Max-Quax/S23_42_NAVAIR_DAD/Requirements Specification.xlsx

Sheet: Version Control
Version No | Date | Version Control Page. Requirements are on the next page
2 | 2022-09-14
2.1 | 2022-09-16
2.2 | 2022-09-21
2.3 | 2022-09-23
2.4 | 2022-10-06
2.5 | 2022-10-15
2.6 | 2022-10-16
2.7 | 2022-10-19
2.8 | 2022-10-26
2.9 | 2022-10-29
2.10. | 2022-11-10
2.11 | 2022-11-13
2.12 | 2022-11-16

Sheet: Requirements Section
Product Name | Data Acquisiton Device
Product Description | The product consists of the Data Acquisition Device (DAD) and its Remote Sensor Array (RSA). The purpose of this device is to aid ground crew in diagnosing, detecting and addressing potential issues on their aircraft. During operation, the user will place the RSA on the aircraft. The user may interface with the DAD’s UI to pair the sensors. While running diagnostics on the aircraft, the DAD will record, process and display real time data for the user. When the user is finished, they should be able to safely power off the device. The DAD should be rechargeable. The user should be able to recharge the DAD while in use.
Product Version | v2.9
Last Updated | 2022-10-29
Category | REQ-# | Priority | Requirement | Version # | Notes
Functional | FUN-1 | 1 | Data Acquisition Device SHALL have sensors that connect wirelessly to the handheld device | v2
 | FUN-2 | 1 | Data Acquisition Device SHALL display live sound data's average intensity | v2
 | FUN-3 | 3 | Data Acquisition Device SHALL display live sound data as an FFT | v2
 | FUN-4 | 1 | Data Acquisition Device SHALL display live vibration data's average intensity | v2
 | FUN-5 | 3 | Data Acquisition Device SHALL display live vibration data as an FFT | v2
 | FUN-6 | 1 | Data Acquisition Device SHALL have a sensor for vibration sensing | v2 | Sensor type is not critical. Velocimeter is industry standard. Return value in meters/sec
 | FUN-8 | 1 | Data Acquisition Device SHALL have a microphone for sound sensing | v2
 | FUN-9 | 1 | Data Acquisition Device SHALL have a sensor for ambient temperature sensing | v2.9 | Sensor type is unimportant. Split this requirement for ambient and point temp (v2.9)
 | FUN-11 | 1 | Data Acquisition Device SHALL have a relative humidity sensor | v2
 | FUN-12 | 2 | Data Acquisition Device SHOULD have wireless sensors that transmit data without need for line of sight to handheld device | v2.7
 | FUN-13 | 3 | Data Acquisition Device SHOULD be able to successfully recover from power loss | v2
 | FUN-14 | 3 | Data Acquisition Device SHALL have enough storage for at least 1 full battery's worth of data collection with an additional 20% margin | v2 | Specific capacity can only be determined after testing
 | FUN-15 | 1 | Data Acquisition Device SHALL comprise of at least one of every type of sensor (vibration, sound, point temperature, ambient temperature, relative humidity) | v2.9 | Adjusted wording to reflect the fact that the customer was agnostic about sensor type, they only care about the type and quality of data we collect. (v2.9)
 | FUN-16 | 5 | Data Acquisition Device SHOULD have hot-swappable sensors | v2.7
 | FUN-17 | 5 | Data Acquisition Device SHOULD update FFT output at least once every 5 seconds (0.2Hz) | v2.5
 | FUN-18 | 4 | Data Acquisition Device SHOULD accommodate at least 8 sensors in total | v2.5 | Max's addition- This was not ported from a previous iteration of the specs. LMK if this shouldn't be in here.
 | FUN-19 | 4 | Data Acquisition Device SHOULD be able to automatically identify each sensor | v2.8
 | FUN-20 | 2 | Data Acquisition Device SHALL provide user with a visual indication of what sensor is which | v2.9 | Edited wording
 | FUN-21 | 4 | Data Acquisition Device SHOULD allow user to attach a description to each sensor from within the UI | v2.8
 | FUN-22 | 1 | Data Acquisition Device SHALL have a sensor for point temperature sensing | v2.9
Performance | PER-1 | 2 | Data Acquisition Device SHALL have a connectivity range of at least 50 feet between the sensors and handheld device | v2
 | PER-2 | 2 | Data Acquisition Device SHALL have readily interpretable output data | v2
 | PER-3 | 3 | Data Acquisition Device SHALL collect at least 10k sound samples per second | v2
 | PER-4 | 3 | Data Acquisition Device SHALL collect at least 10k vibration samples per second | v2
 | PER-5 | 3 | Data Acquisition Device SHALL collect at least 1 temperature sample per second | v2
 | PER-6 | 3 | Data Acquisition Device SHALL collect at least 1 humidity sample per second | v2
 | PER-7 | 3 | Data Acquisition Device SHALL have a maximum microphone sound pressure level of 125dB | v2
 | PER-8 | 3 | Data Acquisition Device SHALL have a maximum vibration sensor intensity of 2 inches per second | v2
 | PER-9 | 3 | Data Acquisition Device SHALL have a maximum temperature sensor temperature of 100C | v2.9 | Removed "212F" (v2.9)
 | PER-10 | 3 | Data Acquisition Device SHALL have a maximum humidity sensor relative humidity of 100% | v2
 | PER-11 | 4 | Remote Sensor Array mounts SHALL be able to withstand vibrations of intensity of at least 2 m/s | v2
 | PER-12 | 4 | Data Acquisition Device SHALL update all data to touchscreeen at least once per second | v2.8 | v2.8
 | PER-13 | 3 | Data Acquisition Device SHALL be able to output minimum temperature readings of -25C | v2.8
 | PER-14a | 3 | Data Acquisition Device SHALL be able to output temperature readings with a precision of 0.5C | v2.9 | After conversation with teammate, this was changed to "precision", rather than "accuracy"
 | PER-14b | 3 | Data Acquisition Device SHALL be able to output vibration readings to within 5% accuracy over its accurate range | v2.8
 | PER-15 | 3 | Data Acquisition Device SHALL be able to output vibration readings over a range of 20Hz to 5kHz | v2.8 | This was described as a "fuzzy bottom" range. Readings were requested to be "fairly flat" over this range
 | PER-16 | 3 | Data Acquisition Device SHALL be able to output humidity readings to within 5% accuracy over its accurate range | v2.8 | Ideal value of 1%
 | PER-17 | 3 | Data Acquisition Device SHALL be able to output humidity readings over an accurate range of 10%-90% humidity | v2.8 | Customer described this as the absolute minimum acceptable. Ideally wants full range.
 | PER-18 | 3 | Data Acquisition Device SHALL have a minimum microphone sound pressure level of 50dB | v2.8
 | PER-19 | 3 | Data Acquisition Device SHALL be able to output sound pressure level readings to within 5dB over its accurate range | v2.8 | Customer described an ideal value of +/- 1dB accuracy
 | PER-20 | 3 | Data Acquisition Device SHALL be able to output microphone readings over a range of 20Hz to 5kHz | v2.8
 | PER-21 | 1 | Data Acquisition Device SHALL have a temperature sensor accurate within +/-5% | v2.8 | Moved requirement. Used to be FUN-10
Compliance
Environmental
Reliability
Power | POW-1 | 3 | Data Acquisition Device SHALL have a battery life of at least 4 hours | v2
 | POW-2 | 2 | Remote Sensor Array SHALL have a battery life of at least 4 hours | v1
Mechanical | MEC-1 | 3 | Data Acquisition Device SHALL have a handheld device weight of no more than 10 pounds | v2
 | MEC-2 | 4 | Remote Sensor array SHALL be smaller than the handheld device | v2.6 | Deleted MEC-5 (duplicate)
 | MEC-3 | 4 | Data Acquisition Device SHOULD have sensors be as small as possible | v2
 | MEC-4 | 2 | Data Acquisition Device SHALL have sensors that can be a coupled to a surface and held in place | v2.11 | Deleted repeated requirement (MEC-6)
 | MEC-7 | 4 | Sensor to sensor array cable length SHALL be limited to less than 65 feet | v2.9 | Changed wording to clarify where the cables are going (2.9)
 | MEC-8 | 5 | Data Acquisition Device SHOULD have some degree of water resistance | v2.8
 | MEC-9 | 5 | Data Acquisition Device SHOULD have some degree of dust resistance | v2.8
 | MEC-10 | 5 | Remote Sensor Array SHOULD have some degree of water resistance | v2.8
 | MEC-11 | 5 | Remote Sensor Array SHOULD have some degree of dust resistance | v2.8
 | MEC-12 | 3 | Data Acquistition Device SHOULD not reach temperatures above 40 C | v2.8 | Actual temperature is interpretation of "too hot to handle"
 | MEC-13 | 2 | Data Acquisition Device SHOULD only use reproducible connection ports | v2.9 | Actual ports used does not matter, as long as they can be found and recreated.
 | MEC-14 | 4 | Data Acquisition Device SHALL have minimum cable lengths of 25 feet | v2.10
 | MEC-15 | 5 | Data Acquisition Device SHOULD have a handheld device with an 8inx3inx6in maximum size | v2.11
 | MEC-16 | 5 | Data Acquisition Device SHOULD have a touchscreen with at least 4in diagonal length | v2.11
Input/Output | I/O-1 | 1 | Data Acquisition Device SHALL output sensor data to standardized removable media | v2
 | I/O-2 | 2 | Data Acquisition Device SHALL have easily accessible output data | v2
 | I/O-3 | 2 | Data Acquisition Device SHALL have easily interpretable output data | v2
Testing
Configuration
Cost
Schedule | SCH-1 | 1 | The Team SHALL present a Critical Design Review by 11/27/2022. | v1 | This will include the schedule, budget status and any relevant project information.
 | SCH-2 | 3 | The Customer and SME SHALL be invited to the CDR no less than 1 week in advance. | v1
 | SCH-3 | 1 | The team SHALL present a Preliminary Design Review by 10/16/22. | v1 | This will include the design architecture, target specification and work breakdown
Safety

Sheet: Verification Devices
Devices Needed
Weight Scale
Camera
Logic Analyzer
Function Generator
Oscilliscope/Spectrum Analyzer
SD Card Reader
Premade Temperature Sensor
Premade Humidity Sensor
Premade Vibration Sensor
Premade Microphone
Power Supply
Laptop
Multimeter
