Max-Quax/S23_42_NAVAIR_DAD/MDE Team 42 Project Files/Hardware/Enclosure Design Files/RSA_BOTTOM_FULL_V2.stl

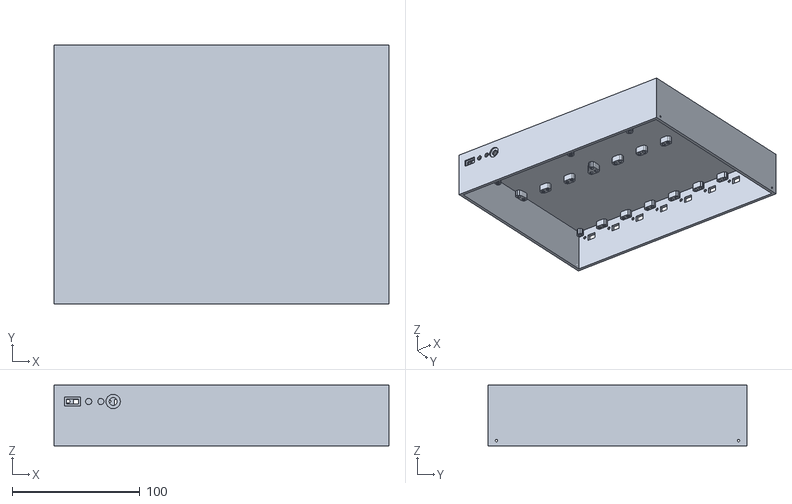
[picture p1: CAD file, 2023-05-04]
MDE Team 42 Project Files/Hardware/Enclosure Design Files/RSA_BOTTOM_FULL_V2.stl
262.6 x 203.0 x 47.6
