Max-Quax/S23_42_NAVAIR_DAD/MDE Team 42 Project Files/Hardware/Enclosure Design Files/RSA_TOP_FULL_V3.stl

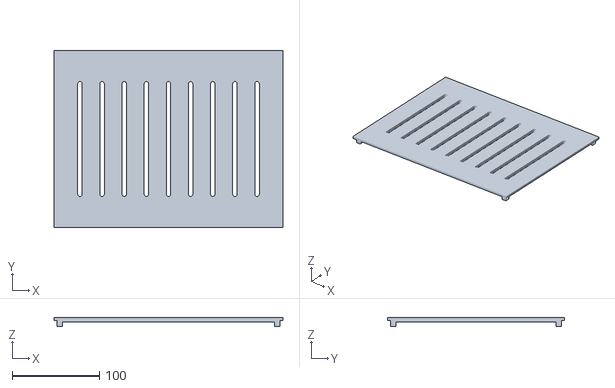
[picture p2: CAD file, 2023-05-04]
MDE Team 42 Project Files/Hardware/Enclosure Design Files/RSA_TOP_FULL_V3.stl
262.6 x 203.0 x 9.84
