Max-Quax/S23_42_NAVAIR_DAD/MDE Team 42 Project Files/Hardware/Enclosure Design Files/SENSOR_BOTTOM_V2.stl

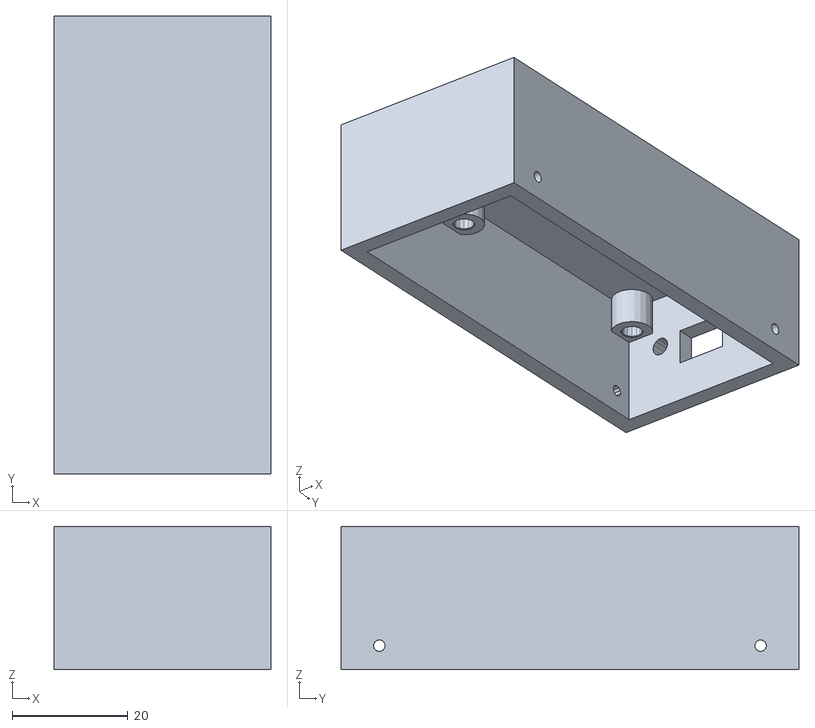
[picture p3: CAD file, 2023-05-04]
MDE Team 42 Project Files/Hardware/Enclosure Design Files/SENSOR_BOTTOM_V2.stl
37.6 x 79.2 x 24.8
