Max-Quax/S23_42_NAVAIR_DAD/MDE Team 42 Project Files/Hardware/Enclosure Design Files/SENSOR_TOP_V2.stl

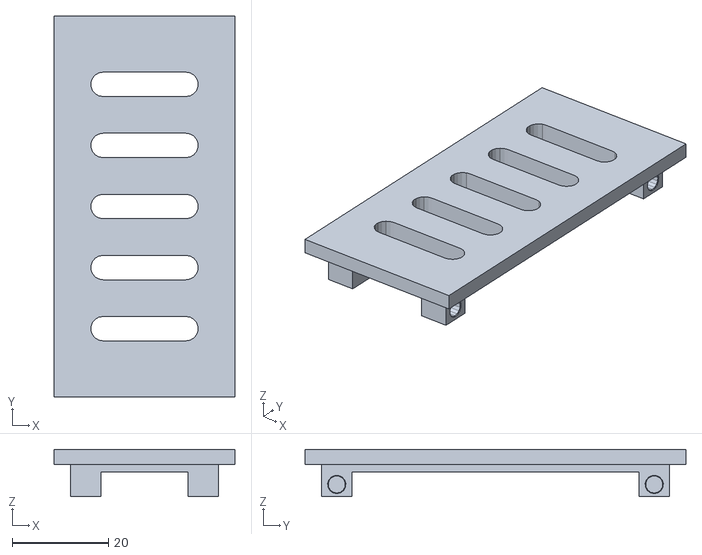
[picture p4: CAD file, 2023-05-04]
MDE Team 42 Project Files/Hardware/Enclosure Design Files/SENSOR_TOP_V2.stl
37.6 x 79.2 x 9.84
