Max-Quax/S23_42_NAVAIR_DAD/MDE Team 42 Project Files/Hardware/Enclosure Design Files/HANDHELD_BOTTOM_V1.stl

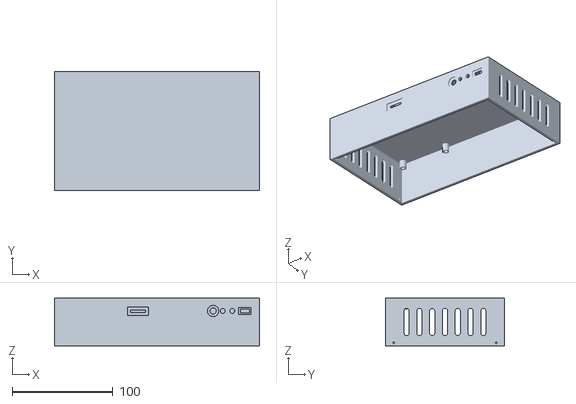
[picture p5: CAD file, 2023-05-04]
MDE Team 42 Project Files/Hardware/Enclosure Design Files/HANDHELD_BOTTOM_V1.stl
203.7 x 118.0 x 47.6
