Max-Quax/S23_42_NAVAIR_DAD/(list of files, cad)

Other CAD files:
MDE Team 42 Project Files/Hardware/Enclosure Design Files/SOUND_SENSOR_TOP_V2.stl
MDE Team 42 Project Files/Hardware/Enclosure Design Files/HANDHELD_BOTTOM.ipt
MDE Team 42 Project Files/Hardware/Enclosure Design Files/HANDHELD_TOP.ipt
MDE Team 42 Project Files/Hardware/Enclosure Design Files/RSA_BOTTOM.ipt
MDE Team 42 Project Files/Hardware/Enclosure Design Files/RSA_TOP.ipt
MDE Team 42 Project Files/Hardware/Enclosure Design Files/SENSOR_BOTTOM.ipt
MDE Team 42 Project Files/Hardware/Enclosure Design Files/SENSOR_TOP.ipt
MDE Team 42 Project Files/Hardware/Enclosure Design Files/SOUND_SENSOR_TOP.ipt
