Max-Quax/S23_42_NAVAIR_DAD/MDE Team 42 Project Files/Hardware/PCB Design Files/Power System Boards/USB Type C PD Schematic.brd

## EAGLE design MDE Team 42 Project Files/Hardware/PCB Design Files/Power System Boards/USB Type C PD Schematic.brd (2023-05-04)

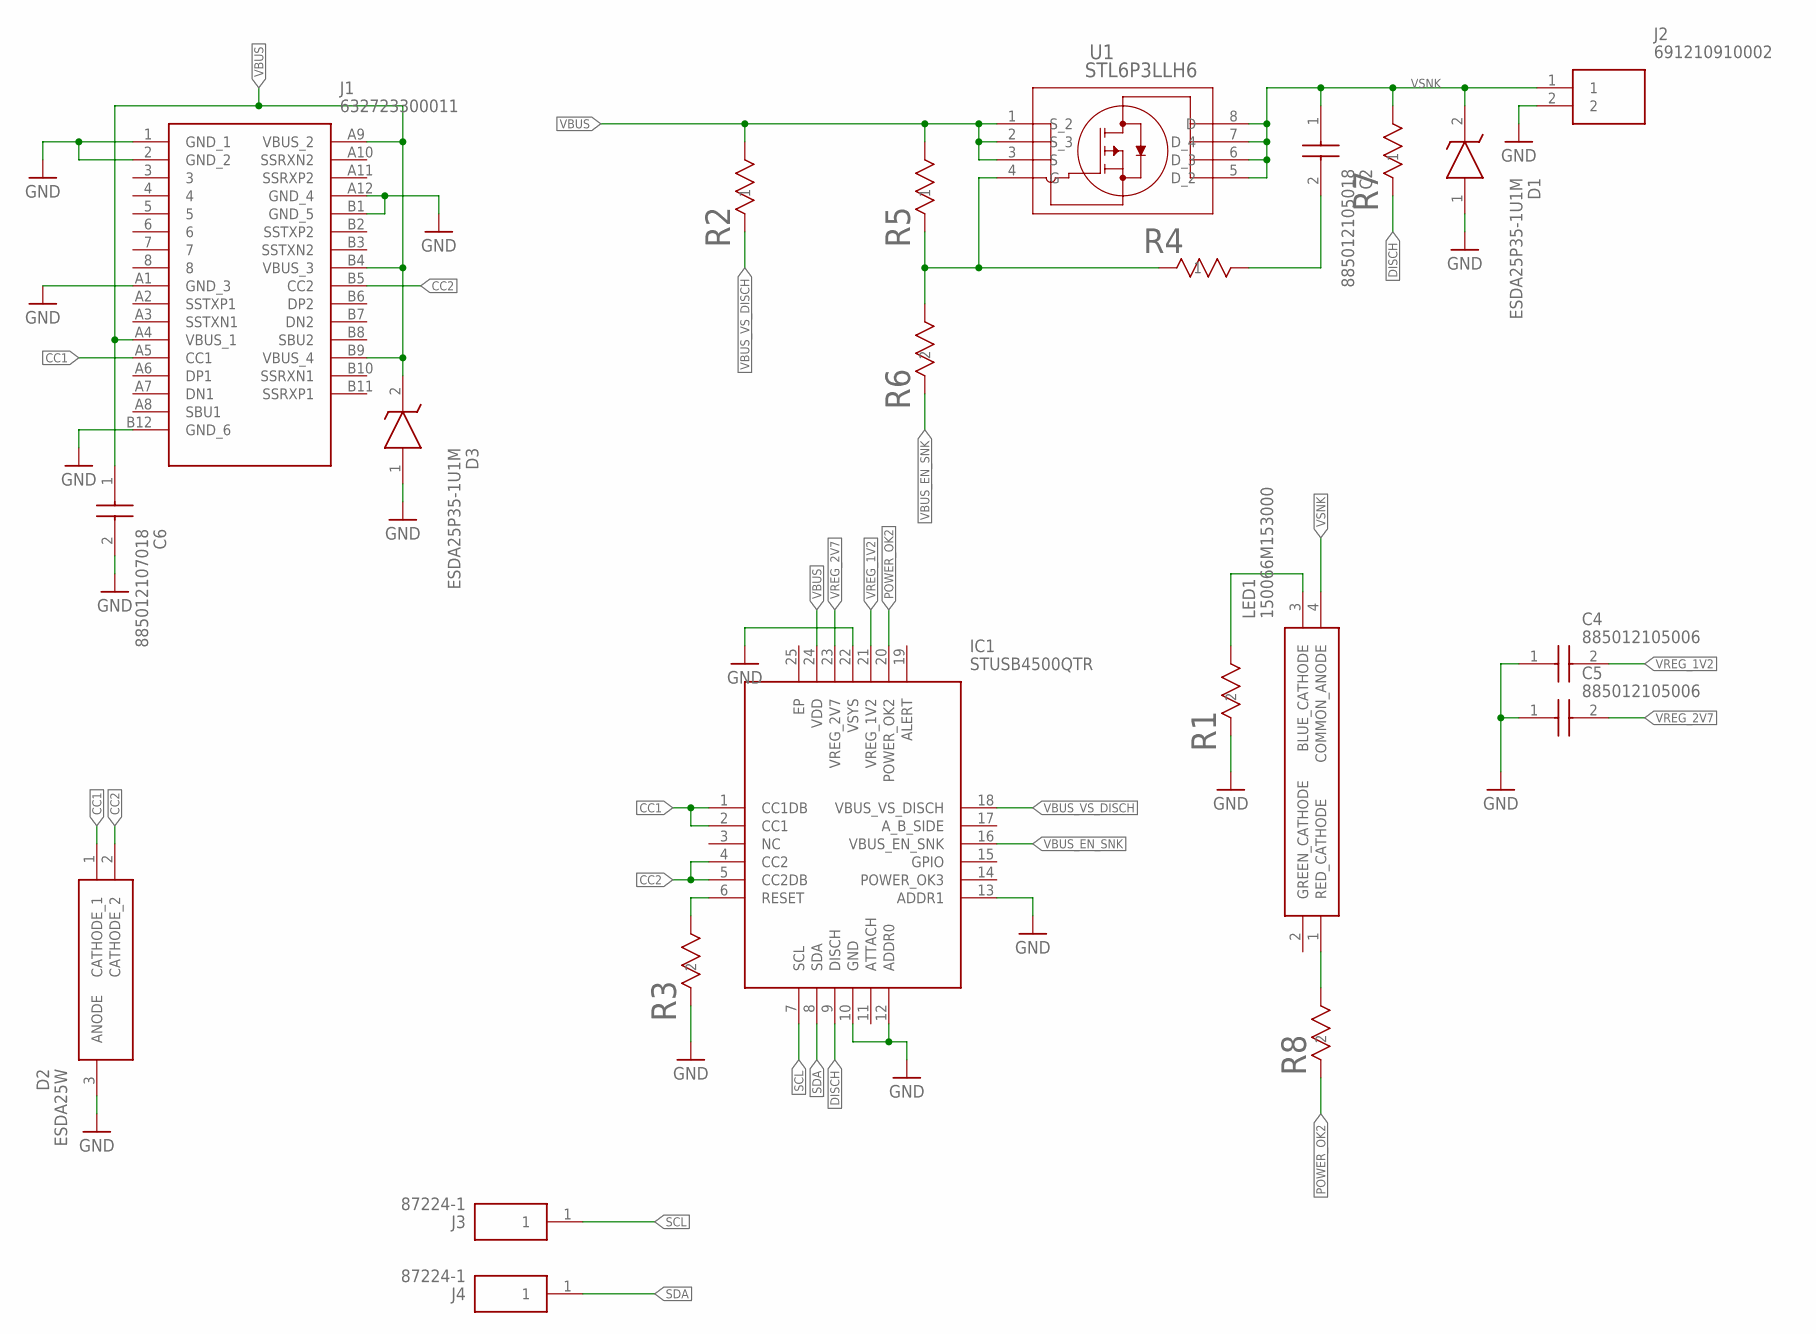
[picture p7: schematic USB Type C PD Schematic.sch]

Parts:
C2: 885012105018; CAPC1005X55N
C4, C5: 885012105006; CAPC1005X55N
C6: 885012107018; CAPC2012X145N
D1, D3: ESDA25P35-1U1M; ESDA8P801U1M
D2: ESDA25W; SOT65P210X110-3N
IC1: STUSB4500QTR; QFN50P400X400X100-25N
J1: 632723300011
J2: 691210910002
J3, J4: 87224-1; HDRV1W66P0X254_1X1_213X254X107
LED1: 150066M153000
R1, R6, R8: RC0402JR-0722KL; RC0402N_YAG
R2, R7: RNCP0603FTD1K00; STA_RNCP0603_STP
R3: RC0402JR-0710KL; RC0402N_YAG
R4: RC0201FR-07100RL; YAG_R0201_YAG
R5: RC0603FR-07100KL; RC0603N_YAG
U1: STL6P3LLH6; POWERFLAT_3P3X3P3_STM

Connections:
CC1: D2.1 (CATHODE_1), IC1.1 (CC1DB), IC1.2 (CC1), J1.A5 (CC1)
CC2: D2.2 (CATHODE_2), IC1.4 (CC2), IC1.5 (CC2DB), J1.B5 (CC2)
DISCH: IC1.9 (DISCH), R7.1
GND: C4.1, C5.1, C6.2, D1.1 (A), D2.3 (ANODE), D3.1 (A), IC1.10 (GND), IC1.12 (ADDR0), IC1.13 (ADDR1), IC1.22 (VSYS), J1.1 (GND_1), J1.2 (GND_2), J1.A1 (GND_3), J1.A12 (GND_4), J1.B1 (GND_5), J1.B12 (GND_6), J2.2, R1.2, R3.2
unnamed: LED1.3 (BLUE_CATHODE), R1.1
unnamed: IC1.6 (RESET), R3.1
unnamed: LED1.1 (RED_CATHODE), R8.1
unnamed: R4.1, R5.1, R6.1, U1.4 (G)
unnamed: C2.2, R4.2
POWER_OK2: IC1.20 (POWER_OK2), R8.2
SCL: IC1.7 (SCL), J3.1
SDA: IC1.8 (SDA), J4.1
VBUS: C6.1, D3.2 (K), IC1.24 (VDD), J1.A4 (VBUS_1), J1.A9 (VBUS_2), J1.B4 (VBUS_3), J1.B9 (VBUS_4), R2.2, R5.2, U1.1 (S_2), U1.2 (S_3), U1.3 (S)
VBUS_EN_SNK: IC1.16 (VBUS_EN_SNK), R6.2
VBUS_VS_DISCH: IC1.18 (VBUS_VS_DISCH), R2.1
VREG_1V2: C4.2, IC1.21 (VREG_1V2)
VREG_2V7: C5.2, IC1.23 (VREG_2V7)
VSNK: C2.1, D1.2 (K), J2.1, LED1.4 (COMMON_ANODE), R7.2, U1.5 (D_2), U1.6 (D_3), U1.7 (D_4), U1.8 (D)

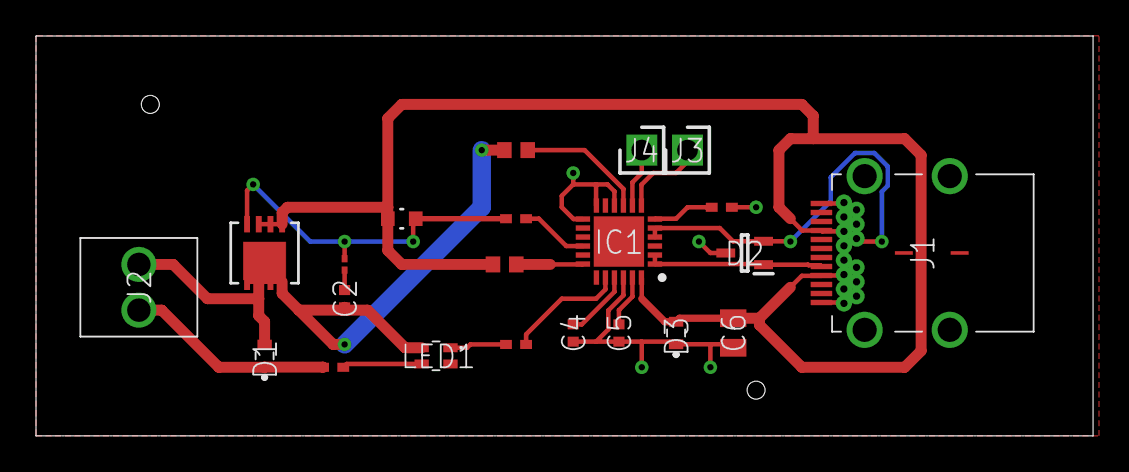
[picture p8: board USB Type C PD Schematic.brd from above]

Board: 2 copper layers, 58.7 x 22.2 mm, 22 parts (0 on the bottom side), 18 nets.
