Max-Quax/S23_42_NAVAIR_DAD/MDE Team 42 Project Files/Hardware/PCB Design Files/Sensor Boards Rev.1/Accelerometer Schematic Rev1.brd

## EAGLE design MDE Team 42 Project Files/Hardware/PCB Design Files/Sensor Boards Rev.1/Accelerometer Schematic Rev1.brd (2023-05-04, an earlier design)

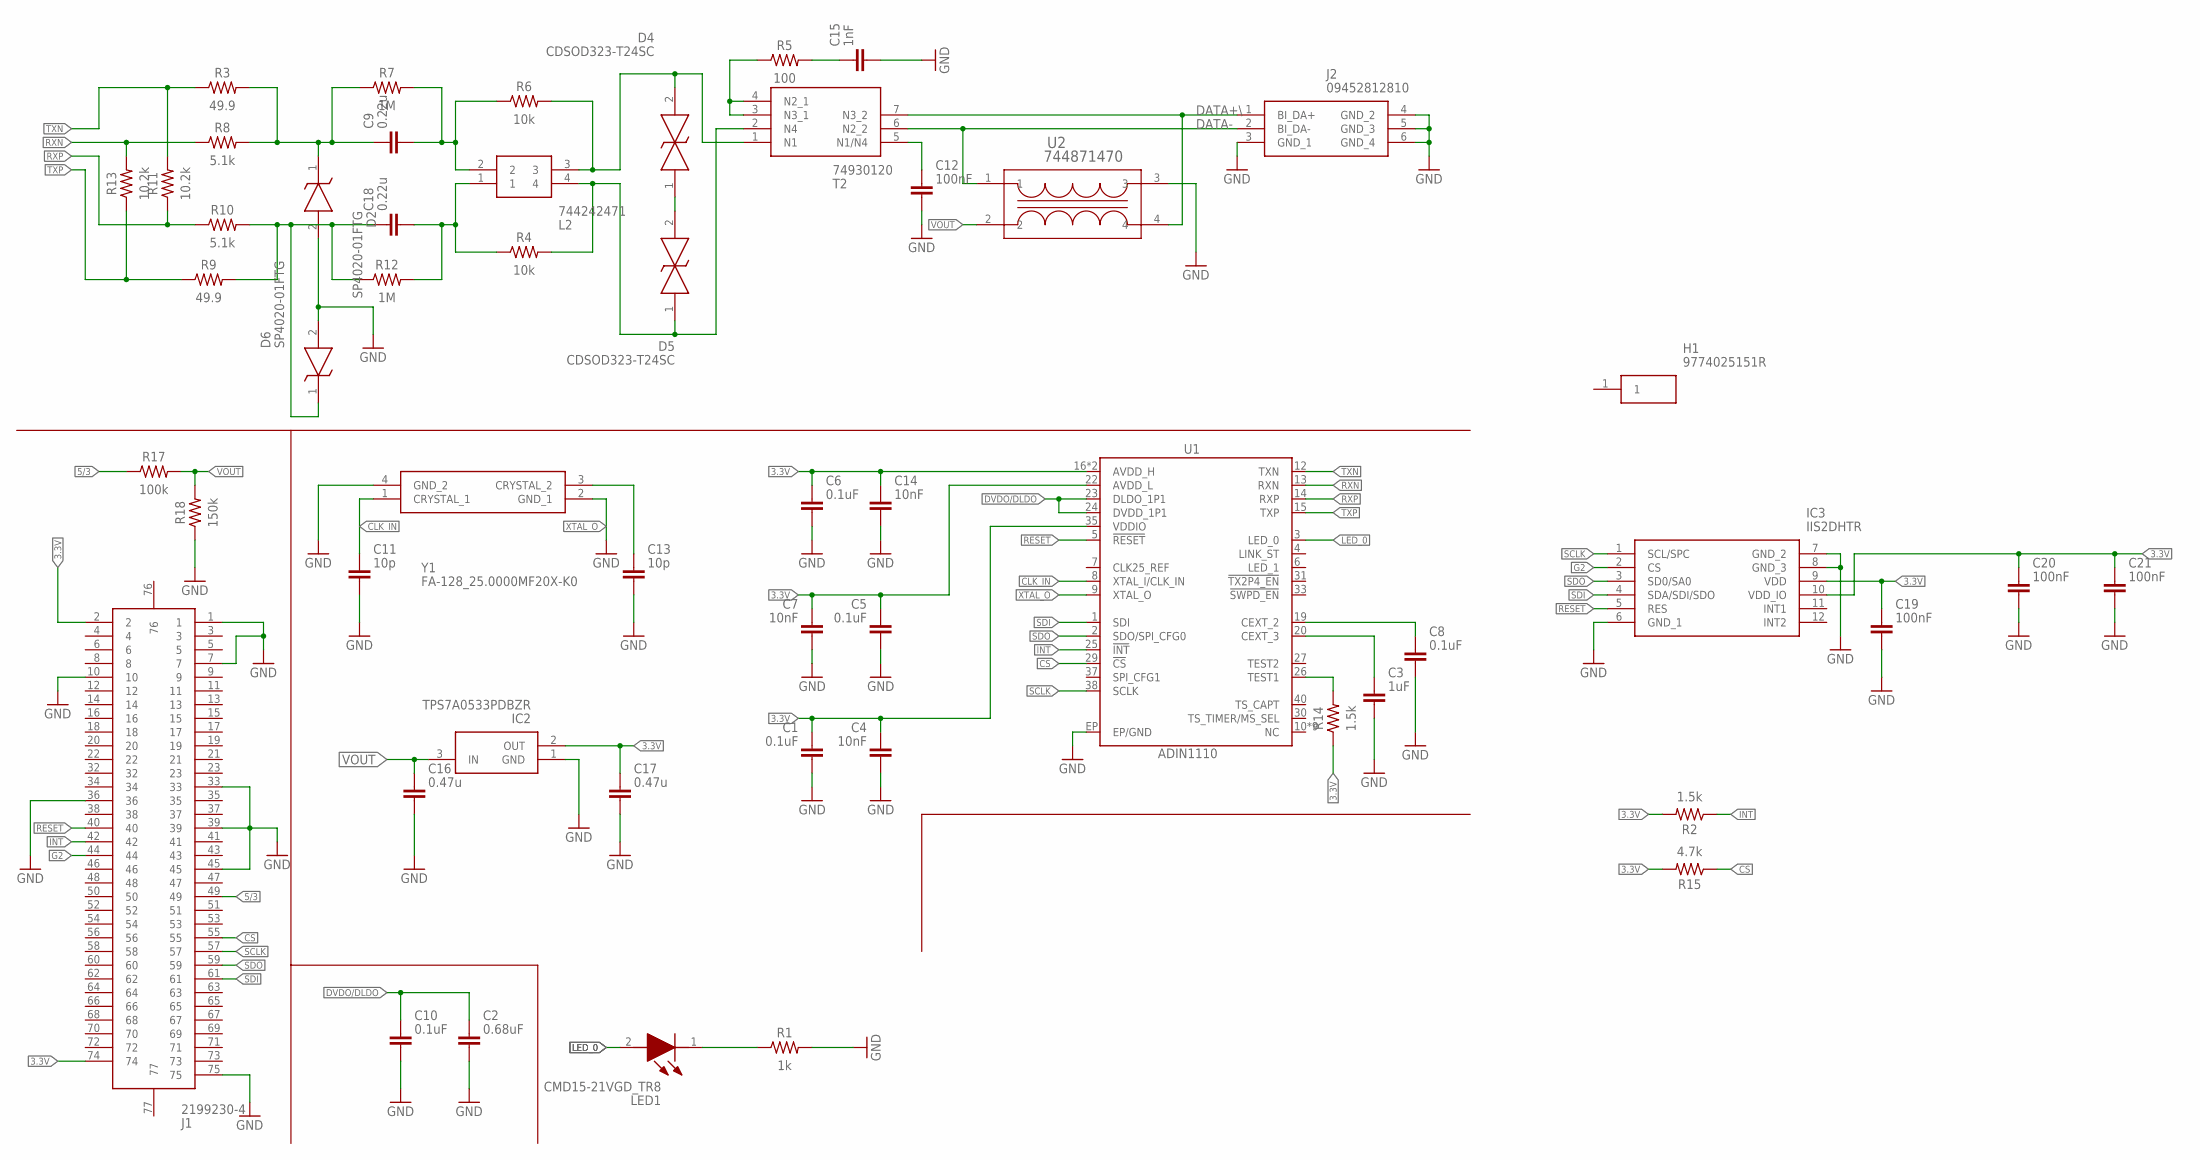
[picture p9: schematic Accelerometer Schematic Rev1.sch]

Parts:
C1, C5, C6, C8, C10: 0.1uF; CAPC1005X60
C2: 0.68uF; CAPC1005X60
C3: 1uF; CAPC1005X60
C4, C7, C14: 10nF; CAPC1005X60
C9, C18: 0.22u; CAPC1005X60
C11, C13: 10p; CAPC1005X60
C12, C19, C20, C21: 100nF; CAPC1005X60
C15: 1nF; CAPC1005X60
C16, C17: 0.47u; CAPC1005X60
D2, D6: SP4020-01FTG; SOD2613X114N
D4, D5: CDSOD323-T24SC; SOD2513X114N
H1: 9774025151R
IC2: TPS7A0533PDBZR; SOT95P237X112-3N
IC3: IIS2DHTR; LGA-12
J1: 2199230-4; 21992304
J2: 09452812810
L2: 744242471
LED1: CMD15-21VGD_TR8; LEDC3215X130N
R1: 1k; RESC1005X40
R2, R14: 1.5k; RESC1005X40
R3, R9: 49.9; RESC1005X40
R4, R6: 10k; RESC1005X40
R5: 100; RESC1005X40
R7, R12: 1M; RESC1005X40
R8, R10: 5.1k; RESC1005X40
R11, R13: 10.2k; RESC1005X40
R15: 4.7k; RESC1005X40
R17: 100k; RESC1005X40
R18: 150k; RESC1005X40
T2: 74930120
U1: ADIN1110; LFCSP-40
U2: 744871470; SMT_871470_WRE
Y1: FA-128_25.0000MF20X-K0; FA128250000MF20XK0

Connections:
3.3V: C1.1, C4.1, C5.1, C6.1, C7.1, C14.1, C17.1, C19.1, C20.1, C21.1, IC2.2 (OUT), IC3.9 (VDD), IC3.10 (VDD_IO), J1.2, J1.74, R2.2, R14.1, R15.2, U1.16 (AVDD_H), U1.17 (AVDD_H), U1.22 (AVDD_L), U1.35 (VDDIO)
5/3: J1.49, R17.1
CLK_IN: C11.1, U1.8 (XTAL_I/CLK_IN), Y1.1 (CRYSTAL_1)
CS: J1.55, R15.1, U1.29 (!CS!)
DATA+\: J2.1 (BI_DA+), T2.7 (N3_2), U2.4
DATA-: J2.2 (BI_DA-), T2.6 (N2_2), U2.1
DVDO/DLDO: C2.1, C10.1, U1.23 (DLDO_1P1), U1.24 (DVDD_1P1)
G2: IC3.2 (CS), J1.44
GND: C1.2, C2.2, C3.2, C4.2, C5.2, C6.2, C7.2, C8.2, C10.2, C11.2, C12.2, C13.2, C14.2, C15.2, C16.2, C17.2, C19.2, C20.2, C21.2, D2.2 (A), D6.2 (A), IC2.1 (GND), IC3.6 (GND_1), IC3.7 (GND_2), IC3.8 (GND_3), J1.1, J1.7, J1.10, J1.33, J1.36, J1.39, J1.45, J1.75, J2.3 (GND_1), J2.4 (GND_2), J2.5 (GND_3), J2.6 (GND_4), R1.2, R18.1, U1.EP (EP/GND), U2.3, Y1.2 (GND_1), Y1.4 (GND_2)
INT: J1.42, R2.1, U1.25 (!INT!)
LED_0: LED1.2 (A), U1.3 (LED_0)
unnamed: C15.1, R5.2
unnamed: LED1.1 (K), R1.1
unnamed: C18.2, L2.1, R4.1, R12.2
unnamed: R14.2, U1.26 (TEST1)
unnamed: C9.2, L2.2, R6.1, R7.2
unnamed: D5.1, L2.4, R4.2, T2.2 (N4)
unnamed: C8.1, U1.19 (CEXT_2)
unnamed: C3.1, U1.20 (CEXT_3)
unnamed: C9.1, D2.1 (K), R3.2, R7.1, R8.2
unnamed: C12.1, T2.5 (N1/N4)
unnamed: R5.1, T2.3 (N3_1), T2.4 (N2_1)
unnamed: C18.1, D6.1 (K), R9.2, R10.2, R12.1
unnamed: D4.2, L2.3, R6.2, T2.1 (N1)
unnamed: D4.1, D5.2
RESET: IC3.5 (RES), J1.40, U1.5 (!RESET!)
RXN: R8.1, R13.2, U1.13 (RXN)
RXP: R10.1, R11.1, U1.14 (RXP)
SCLK: IC3.1 (SCL/SPC), J1.57, U1.38 (SCLK)
SDI: IC3.4 (SDA/SDI/SDO), J1.61, U1.1 (SDI)
SDO: IC3.3 (SD0/SA0), J1.59, U1.2 (SDO/SPI_CFG0)
TXN: R3.1, R11.2, U1.12 (TXN)
TXP: R9.1, R13.1, U1.15 (TXP)
VOUT: C16.1, IC2.3 (IN), R17.2, R18.2, U2.2
XTAL_O: C13.1, U1.9 (XTAL_O), Y1.3 (CRYSTAL_2)

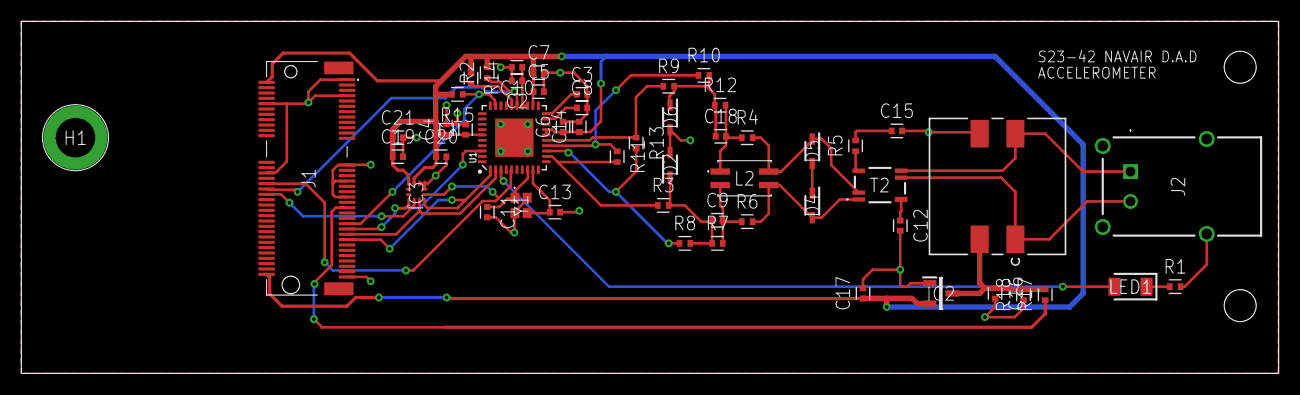
[picture p10: board Accelerometer Schematic Rev1.brd from above]

Board: 2 copper layers, 117.9 x 33.0 mm, 53 parts (0 on the bottom side), 35 nets.
