Max-Quax/S23_42_NAVAIR_DAD/MDE Team 42 Project Files/Hardware/PCB Design Files/Power System Boards/System Power Schematic.brd

## EAGLE design MDE Team 42 Project Files/Hardware/PCB Design Files/Power System Boards/System Power Schematic.brd (2023-05-04)

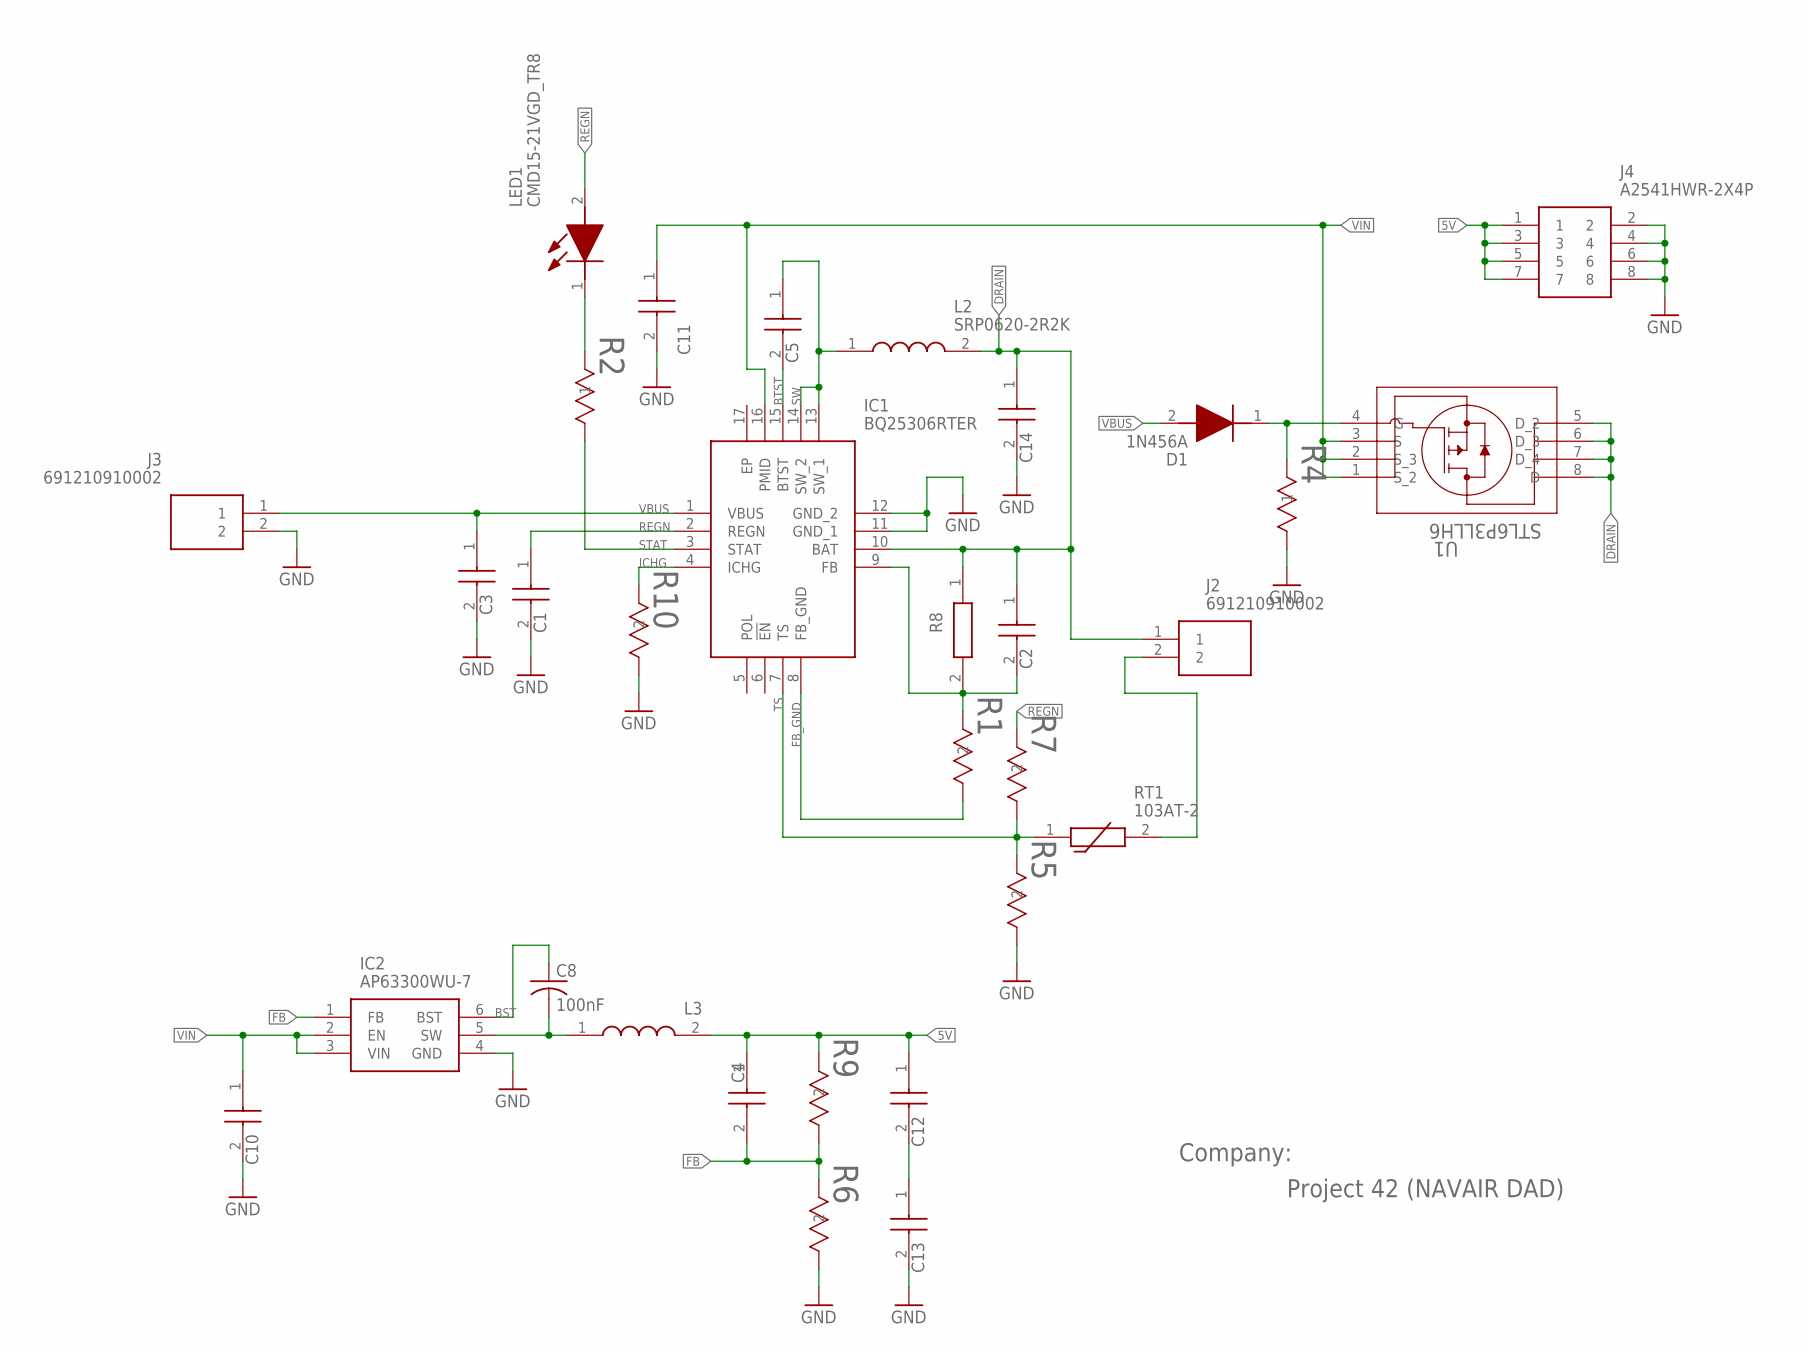
[picture p11: schematic System Power Schematic.sch]

Parts:
C1, C3: TMK107ABJ225KA-T; CAPC1608X90N
C2: CGA1A2X7R1H471K030BA; CAPC1608X90N
C4: CL05C470JB5NNNC; CAPC1005X55N
C5: 885012107018; CAPC2012X145N
C8: 100nF; C0805
C10, C11, C14: CL21A106KAYNNNG; CAPC2012X145N
C12, C13: CL31A226KAHNNNE; CAPC3216X180N
D1: 1N456A; DIO_1N456A
IC1: BQ25306RTER; QFN50P300X300X80-17N
IC2: AP63300WU-7; SOT95P280X90-6N
J2, J3: 691210910002
J4: A2541HWR-2X4P; RHDRRA8W64P254_2X4_1066X850X52
L2: SRP0620-2R2K; SRP06202R2K
L3: SRP0615-6R8K; SRP06152R2K
LED1: CMD15-21VGD_TR8; LEDC3215X130N
R1: ERA-3AEB204V; RC0603N_PAN
R2: RNCP0603FTD1K00; STA_RNCP0603_STP
R4: PNM0603E5001BST5; 0603_VIS
R5: RC0603FR-0712K4L; RC0603N_YAG
R6: RC0603FR-0730K1L; RC0603N_YAG
R7: RC0603FR-073K48L; RC0603N_YAG
R8: RK73H1JTTD1334F; RESC1608X55N
R9: RC0603FR-07158KL; RC0603N_YAG
R10: RN73C1J13K3BTDF; RES0603_RN73_TYCO_TYC
RT1: 103AT-2; 103AT2
U1: STL6P3LLH6; POWERFLAT_3P3X3P3_STM

Connections:
5V: C4.1, C12.1, J4.1, J4.3, J4.5, J4.7, L3.2, R9.2
BST: C8.1, IC2.6 (BST)
BTST: C5.2, IC1.15 (BTST)
DRAIN: C2.1, C14.1, IC1.10 (BAT), J2.1, L2.2, R8.1, U1.5 (D_2), U1.6 (D_3), U1.7 (D_4), U1.8 (D)
FB: C4.2, IC2.1 (FB), R6.2, R9.1
FB_GND: IC1.8 (FB_GND), R1.1
GND: C1.2, C3.2, C10.2, C11.2, C13.2, C14.2, IC1.11 (GND_1), IC1.12 (GND_2), IC2.4 (GND), J3.2, J4.2, J4.4, J4.6, J4.8, R4.2, R5.1, R6.1, R10.1
ICHG: IC1.4 (ICHG), R10.2
unnamed: LED1.1 (K), R2.1
unnamed: C12.2, C13.1
unnamed: D1.1 (K), R4.1, U1.4 (G)
unnamed: J2.2, RT1.2
unnamed: C2.2, IC1.9 (FB), R1.2, R8.2
unnamed: C8.2, IC2.5 (SW), L3.1
REGN: C1.1, IC1.2 (REGN), LED1.2 (A), R7.2
STAT: IC1.3 (STAT), R2.2
SW: C5.1, IC1.13 (SW_1), IC1.14 (SW_2), L2.1
TS: IC1.7 (TS), R5.2, R7.1, RT1.1
VBUS: C3.1, D1.2 (A), IC1.1 (VBUS), J3.1
VIN: C10.1, C11.1, IC1.16 (PMID), IC2.2 (EN), IC2.3 (VIN), U1.1 (S_2), U1.2 (S_3), U1.3 (S)

Notes on the sheet:
Company:
Project 42 (NAVAIR DAD)

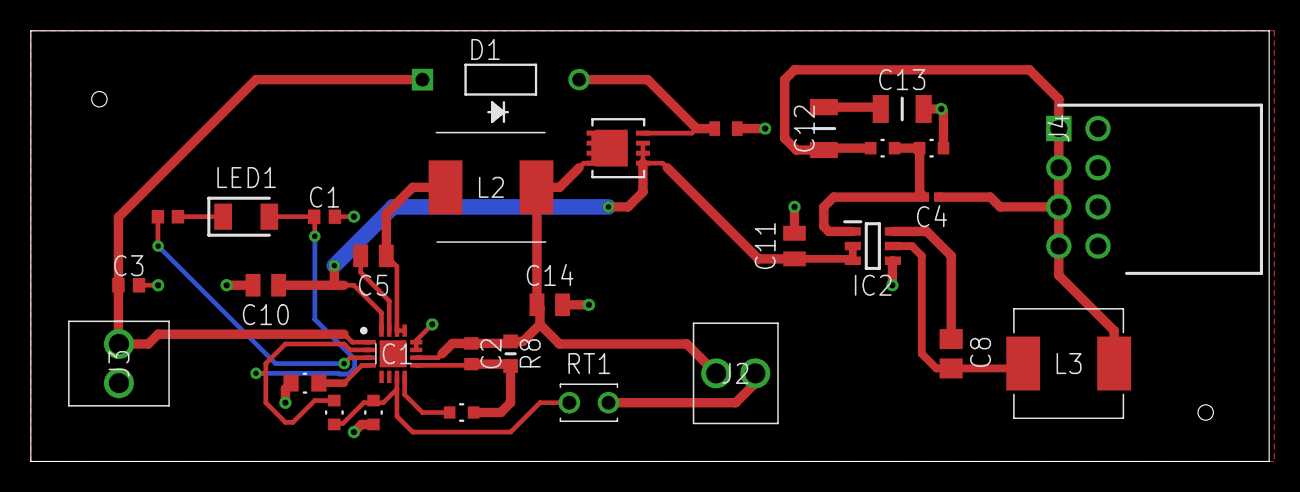
[picture p12: board System Power Schematic.brd from above]

Board: 2 copper layers, 80.3 x 27.9 mm, 31 parts (0 on the bottom side), 20 nets.
