Max-Quax/S23_42_NAVAIR_DAD/(notices)

Notices in the files:
parts and their libraries:
COPYRIGHT: Copyright (C) 2023 Ultra Librarian. All rights reserved.
